akshadgupta72-glitch/servo-door-lock-v3/Round_Handle_Lock_V3.step

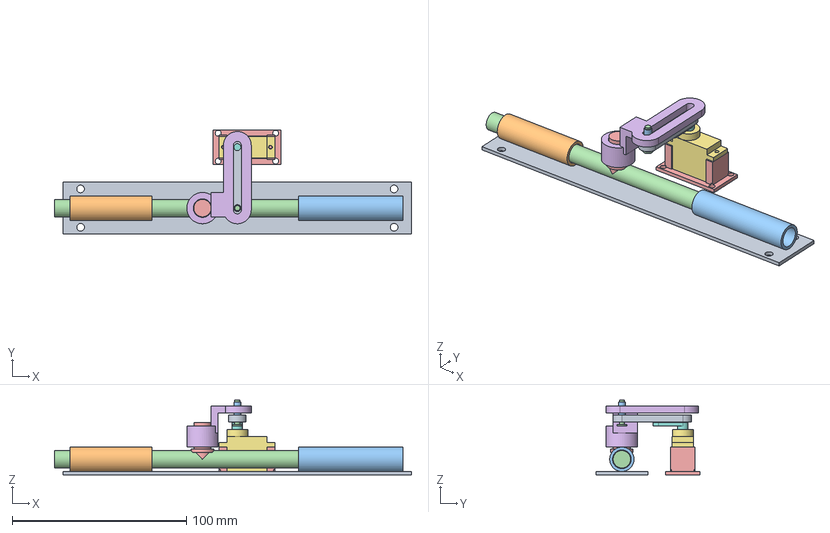
[picture p2: CAD file, 2026-10-30]
Round_Handle_Lock_V3.step
205.0 x 60.0 x 43.0 mm
Lock plate - 200 x 30 mm
Front barrel
Rear barrel
Sliding bolt
Round handle - diameter 10, top 30, smooth length 15 mm
PRINT - glue-on round socket and slotted arm
SG90 9 g - sourced envelope, approximate details
Existing servo horn - do not print spline
PRINT - flat glue face, 35 mm crank radius
Glue layer allowance - 0.5 mm, not a printed part
4 mm OD sleeve on M3 screw - hardware
Pin screw reference
PRINT - provisional servo pedestal
