akshadgupta72-glitch/servo-door-lock-v3/Print_servo_mount_FIT_CHECK.stl

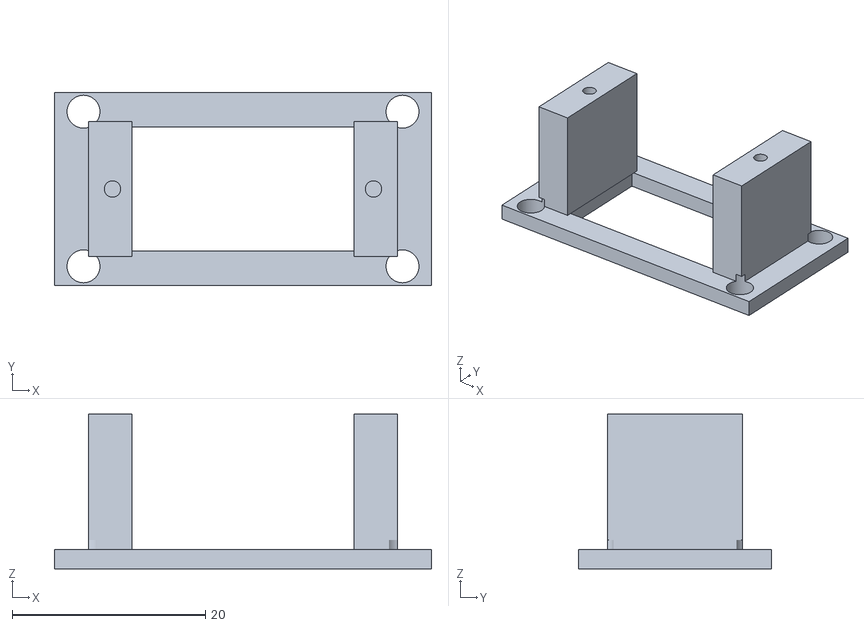
[picture p3: CAD file, 2026-10-30]
Print_servo_mount_FIT_CHECK.stl
39.0 x 20.0 x 16.0
