akshadgupta72-glitch/servo-door-lock-v3/Print_servo_arm_FIT_CHECK.stl

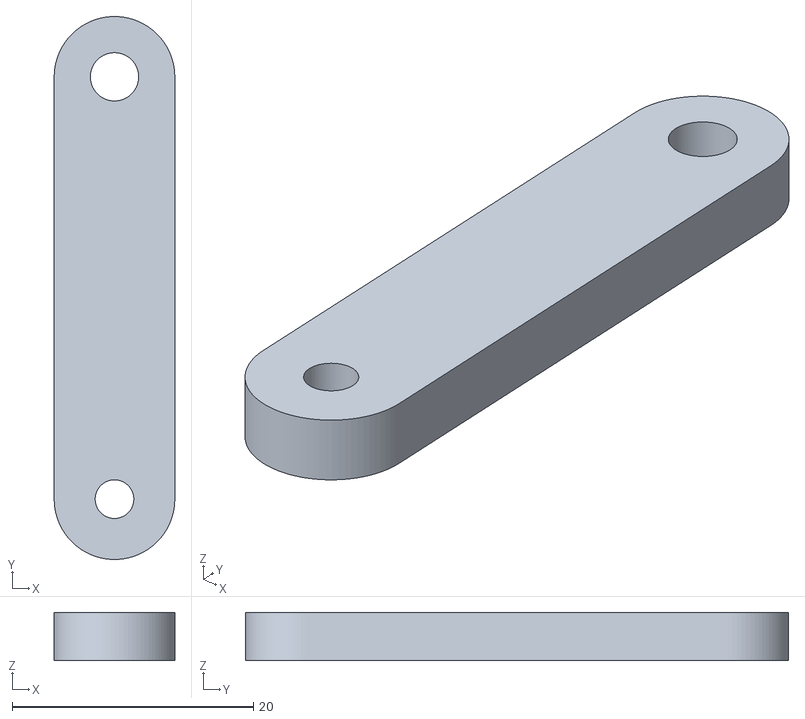
[picture p4: CAD file, 2026-10-30]
Print_servo_arm_FIT_CHECK.stl
10.0 x 45.0 x 4.00
