akshadgupta72-glitch/servo-door-lock-v3/Print_clamp_yoke_FIT_CHECK.stl

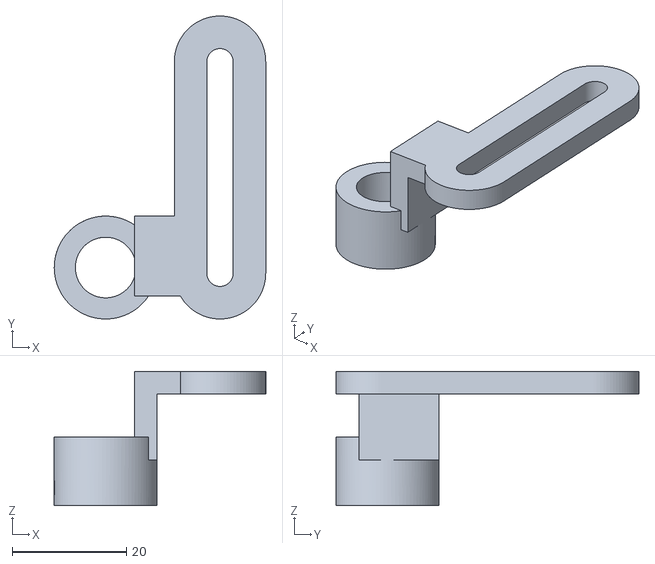
[picture p5: CAD file, 2026-10-30]
Print_clamp_yoke_FIT_CHECK.stl
37.0 x 53.0 x 23.5
