akshadgupta72-glitch/servo-door-lock-v3/(list of files, cad)

Other CAD files:
Round_Handle_Lock_V3.FCStd
