akshadgupta72-glitch/servo-door-lock-v3/(commit log)

2026-10-30 Publish V3 servo door lock design and editable FreeCAD source
    [Print_clamp_yoke_FIT_CHECK.stl, Print_servo_arm_FIT_CHECK.stl, Print_servo_mount_FIT_CHECK.stl, Round_Handle_Lock_V3.FCStd, Round_Handle_Lock_V3.step]
2026-10-31 Add supplied Arduino door lock sketch and configuration guide
